DavinciMorph/InternalDataCollectionV2/CUBoard/CM4 (2).kicad_sch

## KiCad design CUBoard/CM4 (2).kicad_sch (2026-04-11)

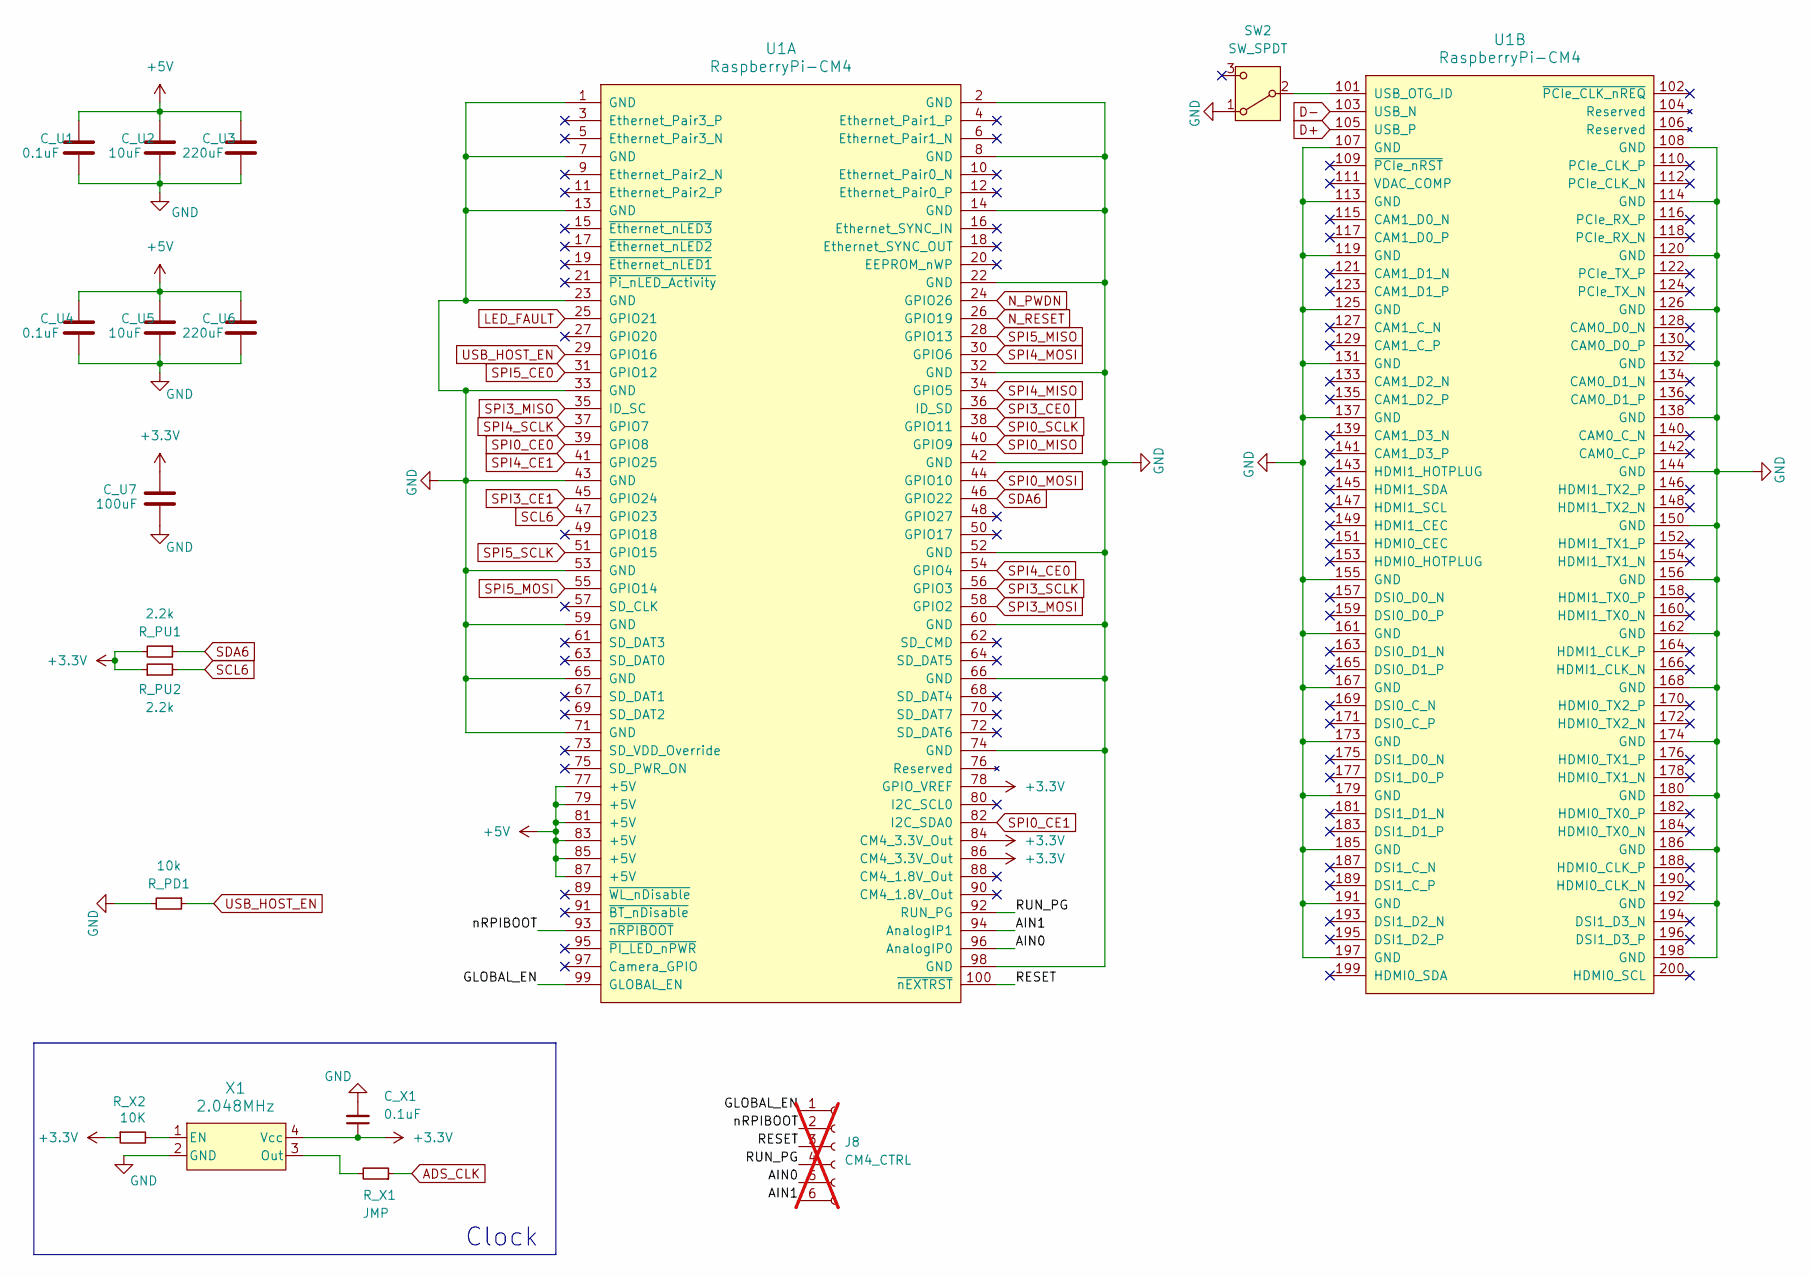
[picture p1: schematic CM4 (2).kicad_sch]

Parts:
C_U1, C_U4: 0.1uF; C_0402_1005Metric; MPN GRM155R71C104KA88J
C_U2, C_U5: 10uF; C_0805_2012Metric; MPN GRM21BR71A106KA73L
C_U3, C_U6: 220uF; CP_Elec_5x3; MPN APXT6R3ARA221ME61G
C_U7: 100uF; C_1206_3216Metric; MPN GRM31CR61A107MEA8L
C_X1: 0.1uF; C_0402_1005Metric; MPN GRM155R71C104KA88J
J8: CM4_CTRL; PinHeader_1x06_P2.54mm_Vertical; not fitted
R_PD1: 10k; R_0402_1005Metric; MPN RC0402FR-0710KL
R_PU1, R_PU2: 2.2k; R_0402_1005Metric; MPN RC0402FR-072K2L
R_X1: JMP; R_0402_1005Metric; MPN RC0402JR-070RL
R_X2: 10K; R_0402_1005Metric; MPN RC0402JR-070RL
SW2: SW_SPDT; SPDT_JS102011JCQN_CNK; MPN JS102011JCQN; JLC PN C221659
U1: RaspberryPi-CM4; Raspberry-Pi-4-Compute-Module
X1: 2.048MHz; IC4_632L3I002M04800_CTS; MPN 632L3I002M04800; JLC PN C2901549

Connections:
+3.3V: C_U7.1, C_X1.1, R_PU1.2, R_PU2.1, R_X2.1, U1.78 (GPIO_VREF), U1.84 (CM4_3.3V_Out), U1.86 (CM4_3.3V_Out), X1.4 (Vcc)
+5V: C_U1.1, C_U2.1, C_U3.1, C_U4.1, C_U5.1, C_U6.1, U1.77 (+5V), U1.79 (+5V), U1.81 (+5V), U1.83 (+5V), U1.85 (+5V), U1.87 (+5V)
ADS_CLK: R_X1.1
AIN0: J8.5, U1.96 (AnalogIP0)
AIN1: J8.6, U1.94 (AnalogIP1)
D+: U1.105 (USB_P)
D-: U1.103 (USB_N)
GLOBAL_EN: J8.1, U1.99 (GLOBAL_EN)
GND: C_U1.2, C_U2.2, C_U3.2, C_U4.2, C_U5.2, C_U6.2, C_U7.2, C_X1.2, R_PD1.2, SW2.1 (A), U1.1 (GND), U1.2 (GND), U1.7 (GND), U1.8 (GND), U1.13 (GND), U1.14 (GND), U1.22 (GND), U1.23 (GND), U1.32 (GND), U1.33 (GND), U1.42 (GND), U1.43 (GND), U1.52 (GND), U1.53 (GND), U1.59 (GND), U1.60 (GND), U1.65 (GND), U1.66 (GND), U1.71 (GND), U1.74 (GND), U1.98 (GND), U1.107 (GND), U1.108 (GND), U1.113 (GND), U1.114 (GND), U1.119 (GND), U1.120 (GND), U1.125 (GND), U1.126 (GND), U1.131 (GND), U1.132 (GND), U1.137 (GND), U1.138 (GND), U1.144 (GND), U1.150 (GND), U1.155 (GND), U1.156 (GND), U1.161 (GND), U1.162 (GND), U1.167 (GND), U1.168 (GND), U1.173 (GND), U1.174 (GND), U1.179 (GND), U1.180 (GND), U1.185 (GND), U1.186 (GND), U1.191 (GND), U1.192 (GND), U1.197 (GND), U1.198 (GND), X1.2 (GND)
LED_FAULT: U1.25 (GPIO21)
N_PWDN: U1.24 (GPIO26)
N_RESET: U1.26 (GPIO19)
unnamed: R_X1.2, X1.3 (Out)
unnamed: R_X2.2, X1.1 (EN)
unnamed: SW2.2 (B), U1.101 (USB_OTG_ID)
RESET: J8.3, U1.100 (~nEXTRST)
RUN_PG: J8.4, U1.92 (RUN_PG)
SCL6: R_PU2.2, U1.47 (GPIO23)
SDA6: R_PU1.1, U1.46 (GPIO22)
SPI0_CE0: U1.39 (GPIO8)
SPI0_CE1: U1.82 (I2C_SDA0)
SPI0_MISO: U1.40 (GPIO9)
SPI0_MOSI: U1.44 (GPIO10)
SPI0_SCLK: U1.38 (GPIO11)
SPI3_CE0: U1.36 (ID_SD)
SPI3_CE1: U1.45 (GPIO24)
SPI3_MISO: U1.35 (ID_SC)
SPI3_MOSI: U1.58 (GPIO2)
SPI3_SCLK: U1.56 (GPIO3)
SPI4_CE0: U1.54 (GPIO4)
SPI4_CE1: U1.41 (GPIO25)
SPI4_MISO: U1.34 (GPIO5)
SPI4_MOSI: U1.30 (GPIO6)
SPI4_SCLK: U1.37 (GPIO7)
SPI5_CE0: U1.31 (GPIO12)
SPI5_MISO: U1.28 (GPIO13)
SPI5_MOSI: U1.55 (GPIO14)
SPI5_SCLK: U1.51 (GPIO15)
USB_HOST_EN: R_PD1.1, U1.29 (GPIO16)
nRPIBOOT: J8.2, U1.93 (~nRPIBOOT)

Notes on the sheet:
Clock
