DavinciMorph/InternalDataCollectionV2/CUBoard/Peripherals (1).kicad_sch

## KiCad design CUBoard/Peripherals (1).kicad_sch (2026-04-11)

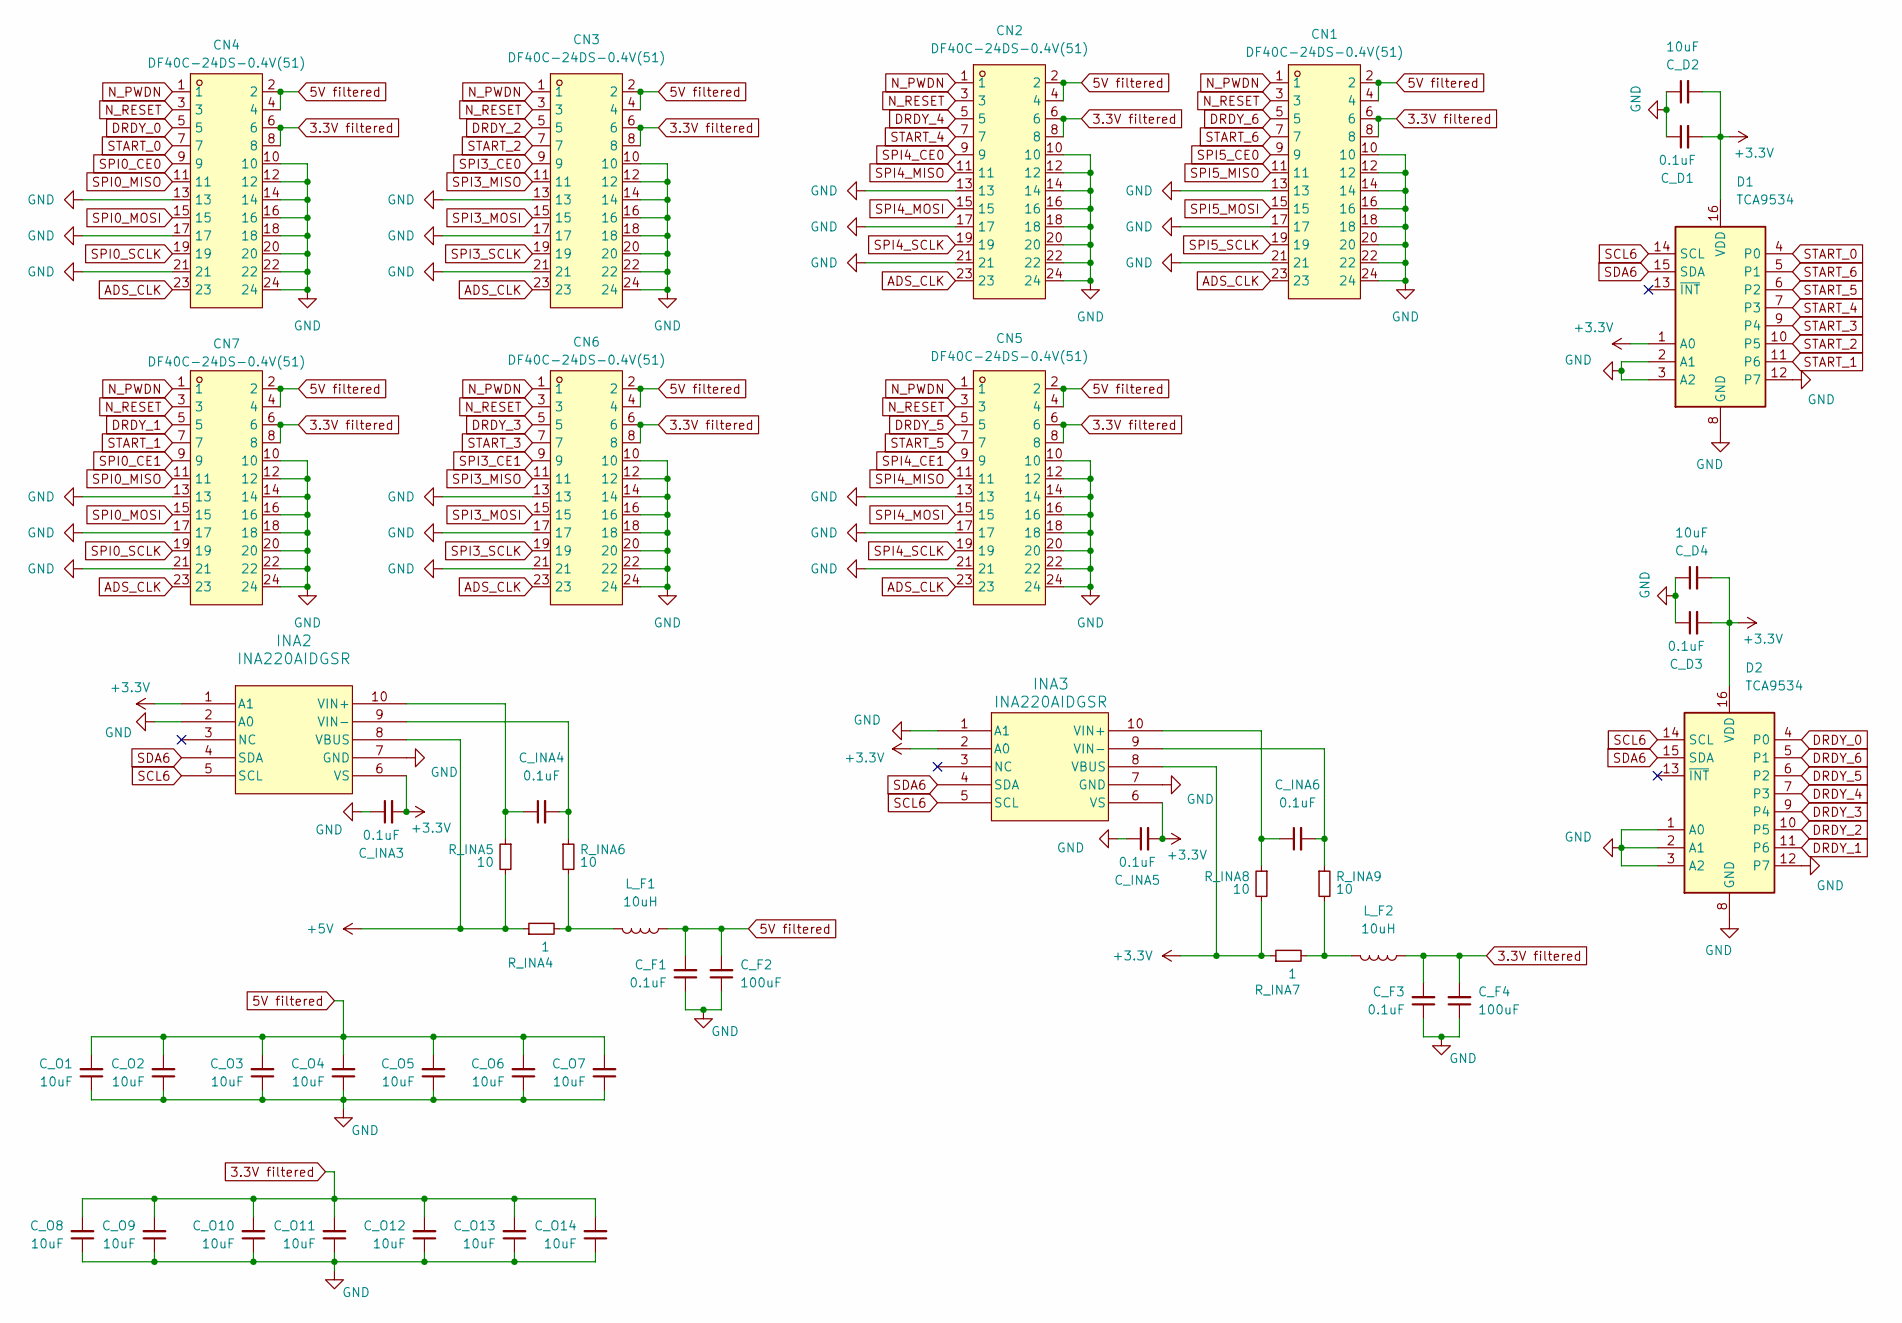
[picture p2: schematic Peripherals (1).kicad_sch]

Parts:
CN1, CN2, CN3, CN4, CN5, CN6, CN7: DF40C-24DS-0.4V(51); DF40C-24DS-0_4V_51; Manufacturer_Part_Number DF40C-24DS-0.4V(51); LCSC Part C424640
C_D1, C_D3: 0.1uF; C_0402_1005Metric; MPN GRM155R71C104KA88J
C_D2, C_D4: 10uF; C_0402_1005Metric; MPN GRM155R61A106ME11D
C_F1, C_F3: 0.1uF; C_0402_1005Metric; MPN GRM155R71C104KA88J
C_F2, C_F4: 100uF; C_1206_3216Metric; MPN GRM31CR61A107MEA8L
C_INA3, C_INA4, C_INA5, C_INA6: 0.1uF; C_0402_1005Metric; MPN GRM155R71C104KA88J
C_O1, C_O2, C_O3, C_O4, C_O5, C_O6, C_O7, C_O8, C_O9, C_O10, C_O11, C_O12, C_O13, C_O14: 10uF; C_0402_1005Metric; MPN GRM155R61A106ME11D
D1, D2: TCA9534; TSSOP-16_4.4x5mm_P0.65mm; MPN TCA9534PWR; JLC PN C783615
INA2, INA3: INA220AIDGSR; VSSOP-10_3x3mm_P0.5mm; MPN INA220AIDGSR; JLC PN C543040
L_F1, L_F2: 10uH; L_0603_1608Metric; MPN LBMF1608T100K
R_INA4, R_INA7: 1; R_0402_1005Metric; MPN RC0402FR-071RL
R_INA5, R_INA6, R_INA8, R_INA9: 10; R_0402_1005Metric; MPN RC0402FR-0710RL

Connections:
3.3V filtered: CN1.6, CN1.8, CN2.6, CN2.8, CN3.6, CN3.8, CN4.6, CN4.8, CN5.6, CN5.8, CN6.6, CN6.8, CN7.6, CN7.8, C_F3.2, C_F4.2, C_O8.2, C_O9.2, C_O10.2, C_O11.2, C_O12.2, C_O13.2, C_O14.2, L_F2.1
5V filtered: CN1.2, CN1.4, CN2.2, CN2.4, CN3.2, CN3.4, CN4.2, CN4.4, CN5.2, CN5.4, CN6.2, CN6.4, CN7.2, CN7.4, C_F1.2, C_F2.2, C_O1.2, C_O2.2, C_O3.2, C_O4.2, C_O5.2, C_O6.2, C_O7.2, L_F1.1
+3.3V: C_D1.2, C_D2.2, C_D3.2, C_D4.2, C_INA3.2, C_INA5.2, D1.1 (A0), D1.16 (VDD), D2.16 (VDD), INA2.1 (A1), INA2.6 (VS), INA3.2 (A0), INA3.6 (VS), INA3.8 (VBUS), R_INA7.1, R_INA8.2
+5V: INA2.8 (VBUS), R_INA4.1, R_INA5.2
ADS_CLK: CN1.23, CN2.23, CN3.23, CN4.23, CN5.23, CN6.23, CN7.23
DRDY_0: CN4.5, D2.4 (P0)
DRDY_1: CN7.5, D2.11 (P6)
DRDY_2: CN3.5, D2.10 (P5)
DRDY_3: CN6.5, D2.9 (P4)
DRDY_4: CN2.5, D2.7 (P3)
DRDY_5: CN5.5, D2.6 (P2)
DRDY_6: CN1.5, D2.5 (P1)
GND: CN1.10, CN1.12, CN1.13, CN1.14, CN1.16, CN1.17, CN1.18, CN1.20, CN1.21, CN1.22, CN1.24, CN2.10, CN2.12, CN2.13, CN2.14, CN2.16, CN2.17, CN2.18, CN2.20, CN2.21, CN2.22, CN2.24, CN3.10, CN3.12, CN3.13, CN3.14, CN3.16, CN3.17, CN3.18, CN3.20, CN3.21, CN3.22, CN3.24, CN4.10, CN4.12, CN4.13, CN4.14, CN4.16, CN4.17, CN4.18, CN4.20, CN4.21, CN4.22, CN4.24, CN5.10, CN5.12, CN5.13, CN5.14, CN5.16, CN5.17, CN5.18, CN5.20, CN5.21, CN5.22, CN5.24, CN6.10, CN6.12, CN6.13, CN6.14, CN6.16, CN6.17, CN6.18, CN6.20, CN6.21, CN6.22, CN6.24, CN7.10, CN7.12, CN7.13, CN7.14, CN7.16, CN7.17, CN7.18, CN7.20, CN7.21, CN7.22, CN7.24, C_D1.1, C_D2.1, C_D3.1, C_D4.1, C_F1.1, C_F2.1, C_F3.1, C_F4.1, C_INA3.1, C_INA5.1, C_O1.1, C_O2.1, C_O3.1, C_O4.1, C_O5.1, C_O6.1, C_O7.1, C_O8.1, C_O9.1, C_O10.1, C_O11.1, C_O12.1, C_O13.1, C_O14.1, D1.2 (A1), D1.3 (A2), D1.8 (GND), D1.12 (P7), D2.1 (A0), D2.2 (A1), D2.3 (A2), D2.8 (GND), D2.12 (P7), INA2.2 (A0), INA2.7 (GND), INA3.1 (A1), INA3.7 (GND)
N_PWDN: CN1.1, CN2.1, CN3.1, CN4.1, CN5.1, CN6.1, CN7.1
N_RESET: CN1.3, CN2.3, CN3.3, CN4.3, CN5.3, CN6.3, CN7.3
unnamed: C_INA4.1, INA2.10 (VIN+), R_INA5.1
unnamed: C_INA4.2, INA2.9 (VIN-), R_INA6.1
unnamed: C_INA6.1, INA3.10 (VIN+), R_INA8.1
unnamed: C_INA6.2, INA3.9 (VIN-), R_INA9.1
unnamed: L_F1.2, R_INA4.2, R_INA6.2
unnamed: L_F2.2, R_INA7.2, R_INA9.2
SCL6: D1.14 (SCL), D2.14 (SCL), INA2.5 (SCL), INA3.5 (SCL)
SDA6: D1.15 (SDA), D2.15 (SDA), INA2.4 (SDA), INA3.4 (SDA)
SPI0_CE0: CN4.9
SPI0_CE1: CN7.9
SPI0_MISO: CN4.11, CN7.11
SPI0_MOSI: CN4.15, CN7.15
SPI0_SCLK: CN4.19, CN7.19
SPI3_CE0: CN3.9
SPI3_CE1: CN6.9
SPI3_MISO: CN3.11, CN6.11
SPI3_MOSI: CN3.15, CN6.15
SPI3_SCLK: CN3.19, CN6.19
SPI4_CE0: CN2.9
SPI4_CE1: CN5.9
SPI4_MISO: CN2.11, CN5.11
SPI4_MOSI: CN2.15, CN5.15
SPI4_SCLK: CN2.19, CN5.19
SPI5_CE0: CN1.9
SPI5_MISO: CN1.11
SPI5_MOSI: CN1.15
SPI5_SCLK: CN1.19
START_0: CN4.7, D1.4 (P0)
START_1: CN7.7, D1.11 (P6)
START_2: CN3.7, D1.10 (P5)
START_3: CN6.7, D1.9 (P4)
START_4: CN2.7, D1.7 (P3)
START_5: CN5.7, D1.6 (P2)
START_6: CN1.7, D1.5 (P1)
