DavinciMorph/InternalDataCollectionV2/CUBoard/Power (1).kicad_sch

## KiCad design CUBoard/Power (1).kicad_sch (2026-04-11)

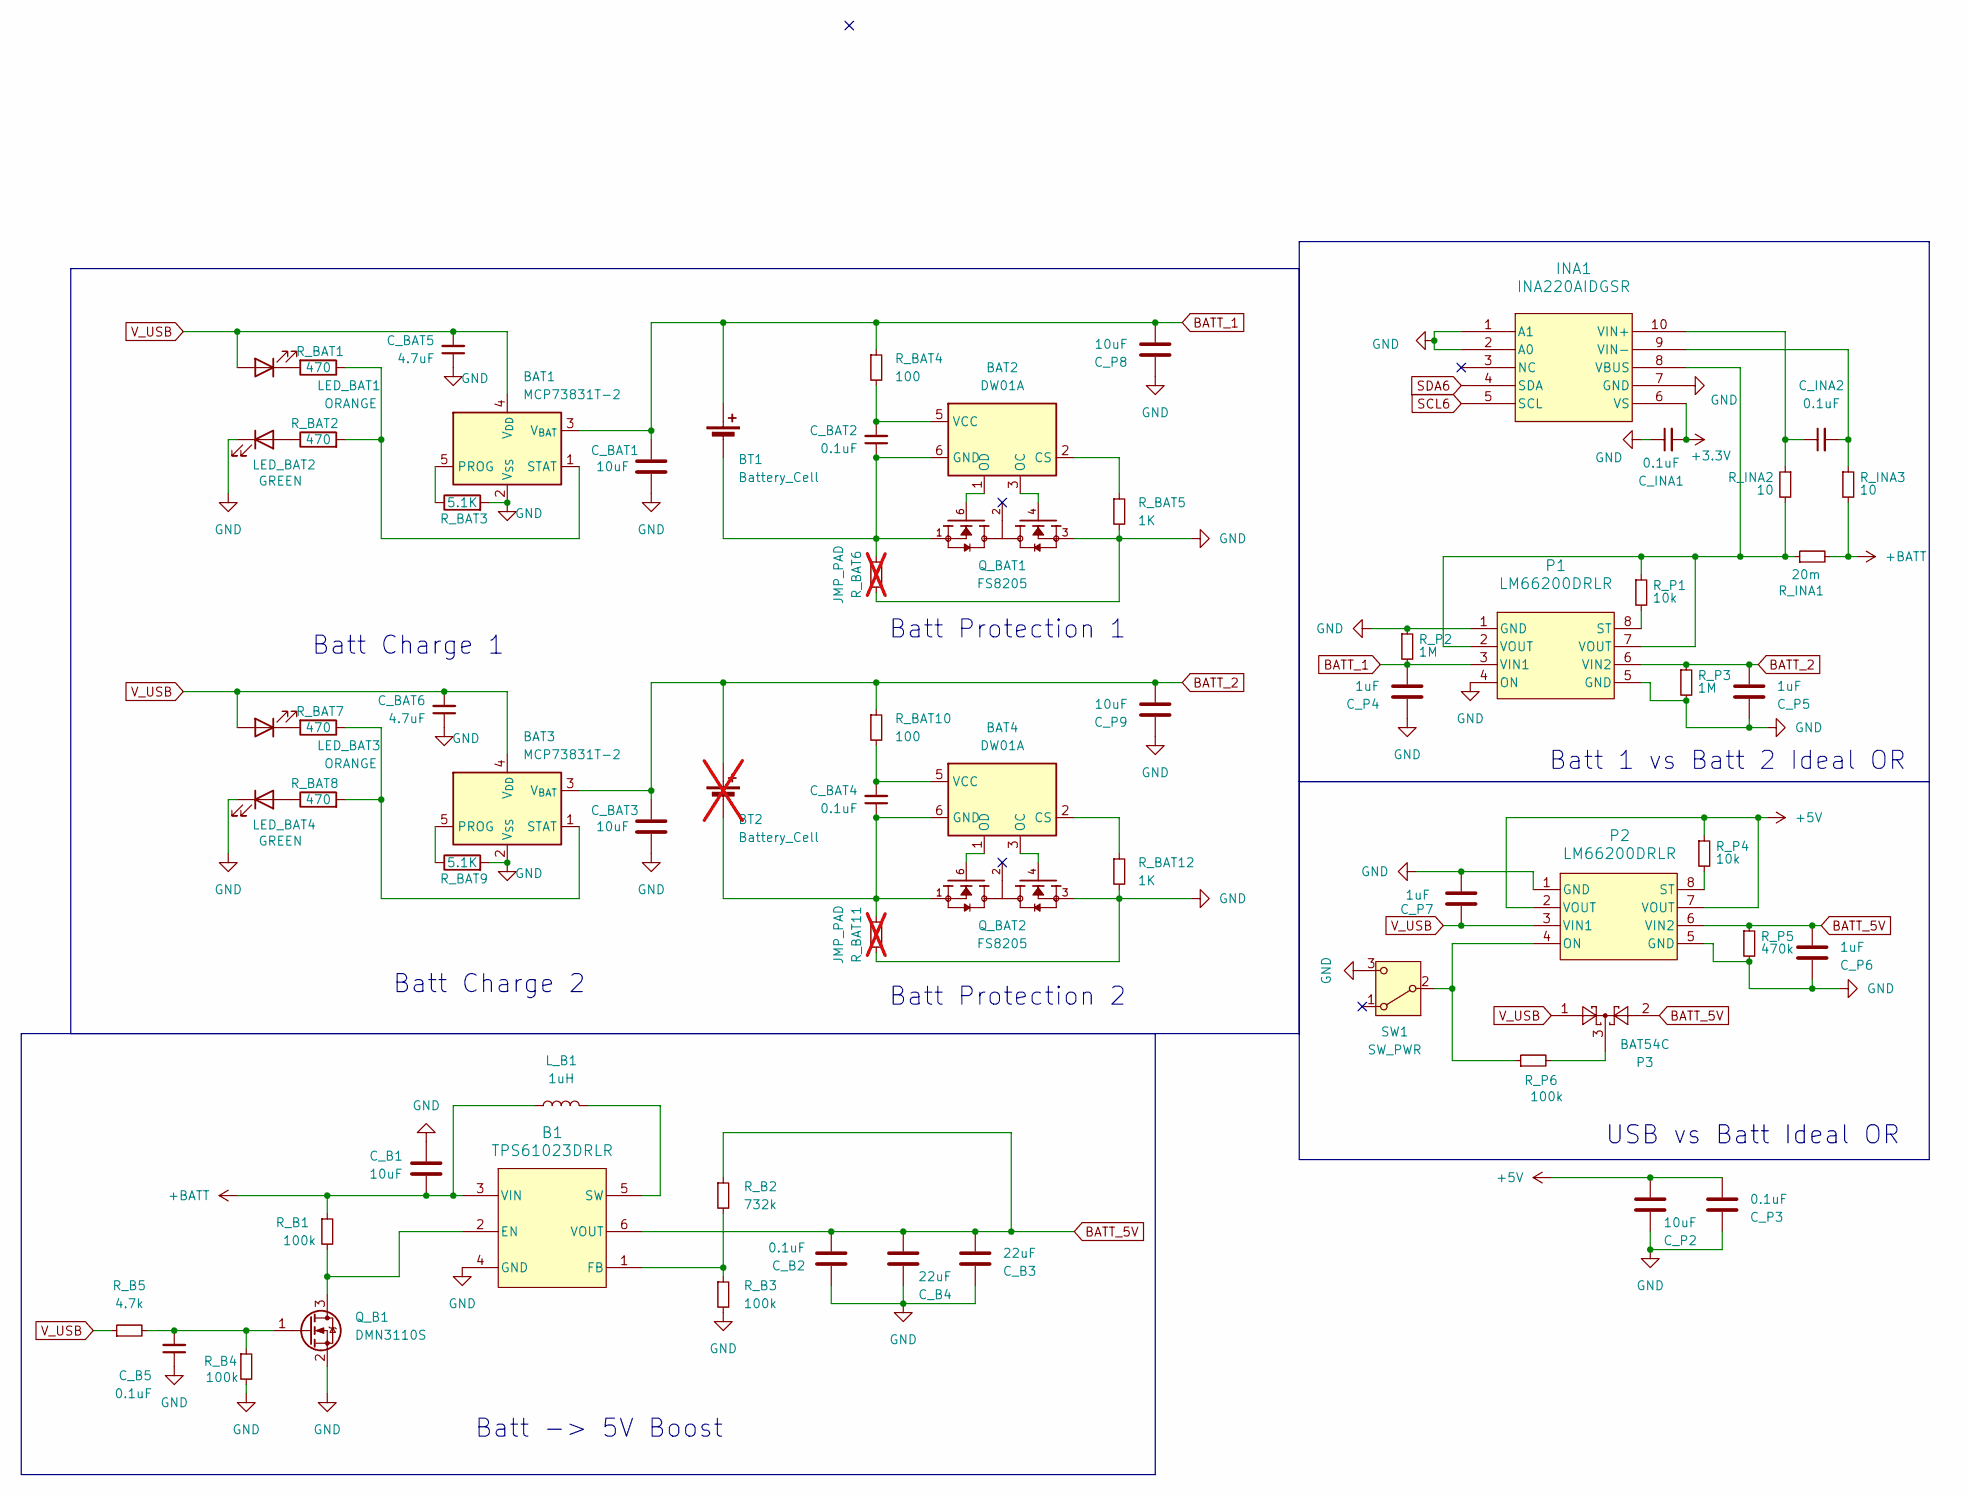
[picture p3: schematic Power (1).kicad_sch]

Parts:
B1: TPS61023DRLR; SOT-563; MPN TPS61023DRLR; JLC PN C919459
BAT1, BAT3: MCP73831T-2; SOT-23-5; MPN MCP73831T-2ACI/OT; JLC PN C424093
BAT2, BAT4: DW01A; SOT-23-6; MPN DW01A; JLC PN C351410
BT1: Battery_Cell; CONN_532610001-SD_02_MOL; MPN 0532610271; JLC PN C189700
BT2: Battery_Cell; CONN_532610001-SD_02_MOL; MPN 0532610271; JLC PN C189700; not fitted
C_B1: 10uF; C_0805_2012Metric; MPN GRM21BR71A106KA73L
C_B2, C_B5: 0.1uF; C_0402_1005Metric; MPN GRM155R71C104KA88J
C_B3, C_B4: 22uF; C_0805_2012Metric; MPN GRM21BZ71A226ME15L
C_BAT1, C_BAT3: 10uF; C_0805_2012Metric; MPN GRM21BR71A106KA73L
C_BAT2, C_BAT4: 0.1uF; C_0402_1005Metric; MPN GRM155R71C104KA88J
C_BAT5, C_BAT6: 4.7uF; C_0805_2012Metric; MPN GRM21BR71C475KE51L
C_INA1, C_INA2: 0.1uF; C_0402_1005Metric; MPN GRM155R71C104KA88J
C_P2, C_P8, C_P9: 10uF; C_0805_2012Metric; MPN GRM21BR71A106KA73L
C_P3: 0.1uF; C_0402_1005Metric; MPN GRM155R71C104KA88J
C_P4, C_P5, C_P6: 1uF; C_0805_2012Metric; MPN GCM21BR71H105KA03L
C_P7: 1uF; C_0603_1608Metric; MPN GCM188R71C105KA64D
INA1: INA220AIDGSR; VSSOP-10_3x3mm_P0.5mm; MPN INA220AIDGSR; JLC PN C543040
LED_BAT1, LED_BAT3: ORANGE; LED_0603_1608Metric; MPN LTST-C193KFKT-5A
LED_BAT2, LED_BAT4: GREEN; LED_0603_1608Metric; MPN LTST-C193KGKT-5A
L_B1: 1uH; L_Vishay_IHLP-2525; MPN IHLP2525CZER1R0M01; JLC PN C845018
P1, P2: LM66200DRLR; SOT-583-8; MPN LM66200DRLR; JLC PN C3235556
P3: BAT54C; SOT-23; MPN BAT54C; JLC PN BAT54C
Q_B1: DMN3110S; SOT-23; MPN DMN3110S-7; JLC PN C461016
Q_BAT1, Q_BAT2: FS8205; SOT95P280X145-6N; MPN FS8205A; JLC PN C908265
R_B1, R_B3, R_B4: 100k; R_0402_1005Metric; MPN RC0402FR-07100KL
R_B2: 732k; R_0402_1005Metric; MPN RC0402FR-07732KL
R_B5: 4.7k; R_0402_1005Metric; MPN RC0402FR-074K7L
R_BAT1, R_BAT2, R_BAT7, R_BAT8: 470; R_0402_1005Metric; MPN RC0402FR-13470RL
R_BAT3, R_BAT9: 5.1K; R_0402_1005Metric; MPN RC0402FR-075K1L
R_BAT4, R_BAT10: 100; R_0402_1005Metric; MPN RC0402FR-07100RL
R_BAT5, R_BAT12: 1K; R_0402_1005Metric; MPN RC0402FR-071KL
R_BAT6, R_BAT11: JMP_PAD; R_0402_1005Metric; MPN RC0402JR-070RL; not fitted
R_INA1: 20m; R_0402_1005Metric; MPN PA0402FRL7T0R02L
R_INA2, R_INA3: 10; R_0402_1005Metric; MPN RC0402FR-0710RL
R_P1, R_P4: 10k; R_0402_1005Metric; MPN RC0402FR-0710KL
R_P2, R_P3: 1M; R_0402_1005Metric; MPN RC0402FR-071ML
R_P5: 470k; R_0402_1005Metric; MPN RC0402FR-07470KL
R_P6: 100k; R_0402_1005Metric; MPN RC0402FR-07100KL
SW1: SW_PWR; EG1215AA; MPN EG1215AA; JLC PN C3664642

Connections:
+3.3V: C_INA1.2, INA1.6 (VS)
+5V: C_P2.1, C_P3.1, P2.2 (VOUT), P2.7 (VOUT), R_P4.1
+BATT: B1.3 (VIN), C_B1.1, L_B1.1, R_B1.1, R_INA1.2, R_INA3.2
BATT_1: BAT1.3 (V_{BAT}), BT1.1 (+), C_BAT1.1, C_P4.1, C_P8.1, P1.3 (VIN1), R_BAT4.1, R_P2.2
BATT_2: BAT3.3 (V_{BAT}), BT2.1 (+), C_BAT3.1, C_P5.1, C_P9.1, P1.6 (VIN2), R_BAT10.1, R_P3.1
BATT_5V: B1.6 (VOUT), C_B2.1, C_B3.1, C_B4.1, C_P6.1, P2.6 (VIN2), P3.2, R_B2.1, R_P5.1
GND: B1.4 (GND), BAT1.2 (V_{SS}), BAT3.2 (V_{SS}), C_B1.2, C_B2.2, C_B3.2, C_B4.2, C_B5.1, C_BAT1.2, C_BAT3.2, C_BAT5.1, C_BAT6.1, C_INA1.1, C_P2.2, C_P3.2, C_P4.2, C_P5.2, C_P6.2, C_P7.1, C_P8.2, C_P9.2, INA1.1 (A1), INA1.2 (A0), INA1.7 (GND), LED_BAT2.1 (K), LED_BAT4.1 (K), P1.1 (GND), P1.4 (ON), P1.5 (GND), P2.1 (GND), P2.5 (GND), Q_B1.2 (S), Q_BAT1.3, Q_BAT2.3, R_B3.2, R_B4.2, R_BAT3.2, R_BAT5.2, R_BAT6.1, R_BAT9.2, R_BAT11.1, R_BAT12.2, R_P2.1, R_P3.2, R_P5.2, SW1.3 (C)
unnamed: B1.1 (FB), R_B2.2, R_B3.1
unnamed: B1.2 (EN), Q_B1.3 (D), R_B1.2
unnamed: B1.5 (SW), L_B1.2
unnamed: BAT1.1 (STAT), R_BAT1.1, R_BAT2.2
unnamed: BAT1.5 (PROG), R_BAT3.1
unnamed: BAT2.1 (OD), Q_BAT1.6
unnamed: BAT2.2 (CS), R_BAT5.1
unnamed: BAT2.3 (OC), Q_BAT1.4
unnamed: BAT2.5 (VCC), C_BAT2.2, R_BAT4.2
unnamed: BAT2.6 (GND), BT1.2 (-), C_BAT2.1, Q_BAT1.1, R_BAT6.2
unnamed: BAT3.1 (STAT), R_BAT7.1, R_BAT8.2
unnamed: BAT3.5 (PROG), R_BAT9.1
unnamed: BAT4.1 (OD), Q_BAT2.6
unnamed: BAT4.2 (CS), R_BAT12.1
unnamed: BAT4.3 (OC), Q_BAT2.4
unnamed: BAT4.5 (VCC), C_BAT4.2, R_BAT10.2
unnamed: BAT4.6 (GND), BT2.2 (-), C_BAT4.1, Q_BAT2.1, R_BAT11.2
unnamed: C_B5.2, Q_B1.1 (G), R_B4.1, R_B5.2
unnamed: C_INA2.1, INA1.10 (VIN+), R_INA2.1
unnamed: C_INA2.2, INA1.9 (VIN-), R_INA3.1
unnamed: INA1.8 (VBUS), P1.2 (VOUT), P1.7 (VOUT), R_INA1.1, R_INA2.2, R_P1.1
unnamed: LED_BAT1.1 (K), R_BAT1.2
unnamed: LED_BAT2.2 (A), R_BAT2.1
unnamed: LED_BAT3.1 (K), R_BAT7.2
unnamed: LED_BAT4.2 (A), R_BAT8.1
unnamed: P1.8 (ST), R_P1.2
unnamed: P2.4 (ON), R_P6.1, SW1.2 (B)
unnamed: P2.8 (ST), R_P4.2
unnamed: P3.3, R_P6.2
unnamed: Q_BAT1.2, Q_BAT1.5
unnamed: Q_BAT2.2, Q_BAT2.5
SCL6: INA1.5 (SCL)
SDA6: INA1.4 (SDA)
V_USB: BAT1.4 (V_{DD}), BAT3.4 (V_{DD}), C_BAT5.2, C_BAT6.2, C_P7.2, LED_BAT1.2 (A), LED_BAT3.2 (A), P2.3 (VIN1), P3.1, R_B5.1

Notes on the sheet:
Batt 1 vs Batt 2 Ideal OR
Batt Charge 2
Batt Charge 1
Batt Protection 2
Batt -> 5V Boost
USB vs Batt Ideal OR
Batt Protection 1
