DavinciMorph/InternalDataCollectionV2/CUBoard/layout.kicad_sch

## KiCad design CUBoard/layout.kicad_sch (2026-04-11)

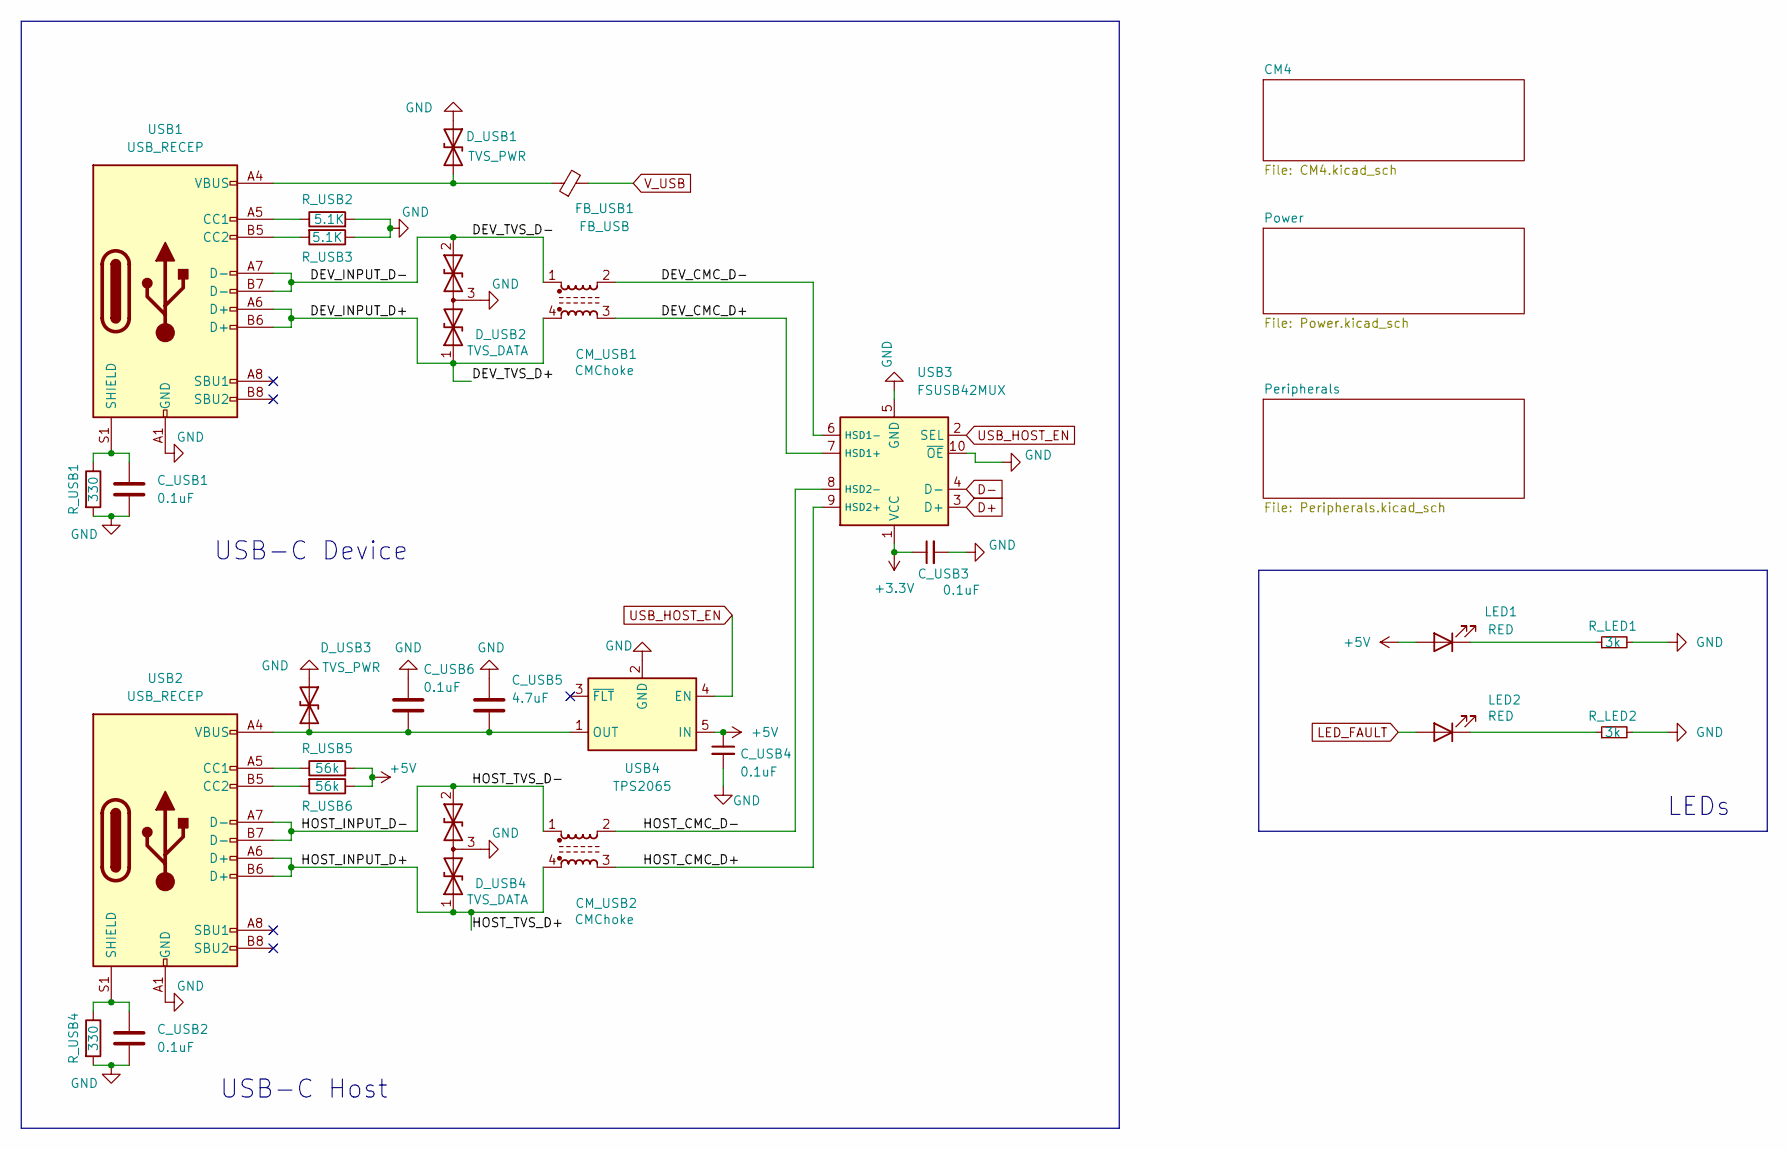
[picture p4: schematic layout.kicad_sch]

Parts:
CM_USB1, CM_USB2: CMChoke; DLM0NSM900HY2D_MUR; MPN DLM0NSM900HY2D; JLC PN C1857796
C_USB1, C_USB2, C_USB3, C_USB4, C_USB6: 0.1uF; C_0402_1005Metric; MPN GRM155R71C104KA88J
C_USB5: 4.7uF; C_0805_2012Metric; MPN GRM21BR71C475KE51L
D_USB1, D_USB3: TVS_PWR; D_SOD-323; MPN DESD5V0S1BA-7; JLC PN C177022
D_USB2, D_USB4: TVS_DATA; SOT-323_SC-70; MPN ESD7002WTT1G; JLC PN C233384
FB_USB1: FB_USB; L_0603_1608Metric; MPN BLM18AG601SN1D
LED1, LED2: RED; LED_0603_1608Metric; MPN LTST-C193KRKT-5A
R_LED1, R_LED2: 3k; R_0402_1005Metric; MPN RC0402FR-073KL
R_USB1, R_USB4: 330; R_0402_1005Metric; MPN RC0402FR-07330RL
R_USB2, R_USB3: 5.1K; R_0402_1005Metric; MPN RC0402FR-075K1L
R_USB5, R_USB6: 56k; R_0402_1005Metric; MPN RC0402FR-0756KL
USB1, USB2: USB_RECEP; GCT_USB4105-GF-A; MPN USB4105-GF-A; JLC PN C2765186
USB3: FSUSB42MUX; MSOP-10_3x3mm_P0.5mm; MPN FSUSB42MUX; JLC PN C11355
USB4: TPS2065; SOT-23-5; MPN TPS2065CDBVR; JLC PN C353882

Connections:
+3.3V: C_USB3.1, USB3.1 (VCC)
+5V: C_USB4.1, LED1.2 (A), R_USB5.2, R_USB6.1, USB4.5 (IN)
D+: USB3.3 (D+)
D-: USB3.4 (D-)
DEV_CMC_D+: CM_USB1.3, USB3.7 (HSD1+)
DEV_CMC_D-: CM_USB1.2, USB3.6 (HSD1-)
DEV_INPUT_D+: CM_USB1.4, D_USB2.1 (A1), USB1.A6 (D+), USB1.B6 (D+)
DEV_INPUT_D-: CM_USB1.1, D_USB2.2 (A2), USB1.A7 (D-), USB1.B7 (D-)
GND: C_USB1.2, C_USB2.2, C_USB3.2, C_USB4.2, C_USB5.1, C_USB6.1, D_USB1.1 (A1), D_USB2.3 (common), D_USB3.1 (A1), D_USB4.3 (common), R_LED1.2, R_LED2.2, R_USB1.2, R_USB2.2, R_USB3.1, R_USB4.2, USB1.A1 (GND), USB1.A12 (GND), USB2.A1 (GND), USB2.A12 (GND), USB3.5 (GND), USB3.10 (~OE), USB4.2 (GND)
HOST_CMC_D+: CM_USB2.3, USB3.9 (HSD2+)
HOST_CMC_D-: CM_USB2.2, USB3.8 (HSD2-)
HOST_INPUT_D+: CM_USB2.4, D_USB4.1 (A1), USB2.A6 (D+), USB2.B6 (D+)
HOST_INPUT_D-: CM_USB2.1, D_USB4.2 (A2), USB2.A7 (D-), USB2.B7 (D-)
LED_FAULT: LED2.2 (A)
unnamed: C_USB1.1, R_USB1.1, USB1.S1 (SHIELD)
unnamed: C_USB2.1, R_USB4.1, USB2.S1 (SHIELD)
unnamed: C_USB5.2, C_USB6.2, D_USB3.2 (A2), USB2.A4 (VBUS), USB2.A9 (VBUS), USB4.1 (OUT)
unnamed: D_USB1.2 (A2), FB_USB1.1, USB1.A4 (VBUS), USB1.A9 (VBUS)
unnamed: LED1.1 (K), R_LED1.1
unnamed: LED2.1 (K), R_LED2.1
unnamed: R_USB2.1, USB1.A5 (CC1)
unnamed: R_USB3.2, USB1.B5 (CC2)
unnamed: R_USB5.1, USB2.A5 (CC1)
unnamed: R_USB6.2, USB2.B5 (CC2)
USB_HOST_EN: USB3.2 (SEL), USB4.4 (EN)
V_USB: FB_USB1.2

Notes on the sheet:
USB-C Device
LEDs
USB-C Host
