DavinciMorph/InternalDataCollectionV2/pi/config.txt

# For more options and information see
# http://rptl.io/configtxt
# Some settings may impact device functionality. See link above for details

# Uncomment some or all of these to enable the optional hardware interfaces
#dtparam=i2c_arm=on
dtparam=i2c_arm=off
#dtparam=i2s=on
#dtparam=spi=on
dtoverlay=spi0-2cs,cs0_pin=8,cs1_pin=44
#dtoverlay=gpio-cs-overlay

# Enable additional hardware SPI buses for the CM4
dtoverlay=spi3-2cs
dtoverlay=spi3-dma
dtoverlay=spi4-2cs
dtoverlay=spi4-dma
dtoverlay=spi5-1cs
dtoverlay=dma40-expand
dtoverlay=spi5-dma
dtoverlay=ads1299

# Audio disabled — reduces EMI (no audio needed for headless acquisition)
dtparam=audio=off

# Additional overlays and parameters are documented
# /boot/firmware/overlays/README

# Camera/display auto-detect disabled — reduces periodic bus probing EMI
camera_auto_detect=0
display_auto_detect=0

# Automatically load initramfs files, if found
auto_initramfs=1

# Enable DRM VC4 V3D driver (HDMI output disabled to eliminate GPU EMI)
dtoverlay=vc4-kms-v3d,noaudio
max_framebuffers=0
hdmi_blanking=2

# Don't have the firmware create an initial video= setting in cmdline.txt.
# Use the kernel's default instead.
disable_fw_kms_setup=1

# Run in 64-bit mode
arm_64bit=1

# Disable compensation for displays with overscan
disable_overscan=1

# Run as fast as firmware / board allows
arm_boost=1

[cm4]
# Enable host mode on the 2711 built-in XHCI USB controller.
# This line should be removed if the legacy DWC2 controller is required
# (e.g. for USB device mode) or if USB support is not required.
otg_mode=1

[cm5]
dtoverlay=dwc2,dr_mode=host

[all]
# Disable Bluetooth — radio transceiver creates broadband EMI
dtoverlay=disable-bt

# Disable composite TV output — analog video DAC not needed
enable_tvout=0

dtoverlay=i2c-gpio,bus=6,i2c_gpio_sda=22,i2c_gpio_scl=23
