DavinciMorph/InternalDataCollectionV2/Cpp Implementation/src/acquisition/engine.cpp

#include "acquisition/engine.hpp"
#include "acquisition/bus_worker.hpp"
#include "acquisition/drdy_poller.hpp"
#include "ads1299/spi_device.hpp"
#include "ads1299/registers.hpp"
#include "streaming/server.hpp"

#include <cstdio>
#include <cstring>
#include <sched.h>
#include <pthread.h>
#include <sys/mman.h>
#include <fcntl.h>
#include <unistd.h>
#include <time.h>
#include <float.h>

namespace ads1299 {

double AcquisitionEngine::clock_now() {
    struct timespec ts;
    clock_gettime(CLOCK_MONOTONIC, &ts);
    return ts.tv_sec + ts.tv_nsec * 1e-9;
}

AcquisitionEngine::AcquisitionEngine(
    std::vector<ADS1299Device*>& devices,
    std::vector<BusWorker*>& workers,
    DRDYPoller& drdy_poller,
    SPSCRing<Sample>& ring)
    : devices_(devices)
    , workers_(workers)
    , drdy_poller_(drdy_poller)
    , ring_(ring)
    , num_ports_(static_cast<int>(devices.size()))
    , total_channels_(0)
    , total_samples_(0)
    , drdy_timeouts_(0)
    , corruption_count_(0)
    , drop_count_(0)
    , cycle_sum_ms_(0)
    , min_cycle_ms_(1e9)
    , max_cycle_ms_(0)
    , min_dt_ms_(1e9)
    , max_dt_ms_(0)
    , start_time_(0)
    , last_sample_time_(0)
    , last_stats_time_(0)
{
    std::memset(port_map_, 0, sizeof(port_map_));

    // Compute total channels and build port-to-worker mapping
    for (int p = 0; p < num_ports_; ++p) {
        total_channels_ += devices_[p]->config().num_devices * CHANNELS_PER_DEVICE;

        // Find which worker owns this port
        for (size_t w = 0; w < workers_.size(); ++w) {
            for (int wp = 0; wp < workers_[w]->port_count(); ++wp) {
                if (workers_[w]->device(wp) == devices_[p]) {
                    port_map_[p].worker_idx = static_cast<int>(w);
                    port_map_[p].port_idx_in_worker = wp;
                }
            }
        }
    }
}

void AcquisitionEngine::run(volatile sig_atomic_t& running) {
    // --- RT Hardening ---

    // Lock all pages — prevents page faults in hot loop
    mlockall(MCL_CURRENT | MCL_FUTURE);

    // Pre-fault stack (128KB)
    volatile char stack_prefault[128 * 1024];
    for (size_t i = 0; i < sizeof(stack_prefault); i += 4096) {
        stack_prefault[i] = 0;
    }

    // Prevent deep C-states (keep /dev/cpu_dma_latency open for process lifetime)
    int pm_fd = ::open("/dev/cpu_dma_latency", O_WRONLY);
    if (pm_fd >= 0) {
        int32_t zero = 0;
        ::write(pm_fd, &zero, sizeof(zero));
        // Keep fd open — closing would re-enable deep C-states
    }

    // Pin to isolated core 3
    cpu_set_t cpuset;
    CPU_ZERO(&cpuset);
    CPU_SET(3, &cpuset);
    pthread_setaffinity_np(pthread_self(), sizeof(cpu_set_t), &cpuset);

    // Set SCHED_FIFO priority 50
    struct sched_param param{};
    param.sched_priority = 50;
    sched_setscheduler(0, SCHED_FIFO, &param);

    std::printf("  Engine: core 3, SCHED_FIFO 50, mlockall, %d channels\n", total_channels_);

    // Pre-allocated sample for the hot loop
    Sample sample;
    std::memset(&sample, 0, sizeof(sample));
    sample.num_channels = static_cast<uint16_t>(total_channels_);

    start_time_ = clock_now();
    last_stats_time_ = start_time_;
    last_sample_time_ = 0;

    PortData port_data;

    while (running) {
        // 1. Poll DRDY via I2C (8ms timeout = corruption threshold)
        if (!drdy_poller_.poll(0.008)) {
            drdy_timeouts_++;
            continue;
        }

        double cycle_start = clock_now();

        // 2. Trigger all bus workers in parallel
        for (auto* w : workers_) {
            w->trigger();
        }

        // 3. Wait for all bus workers to complete
        for (auto* w : workers_) {
            w->wait_done();
        }

        // 4. Parse raw data into Sample struct
        double timestamp = cycle_start - start_time_;
        sample.timestamp = timestamp;
        sample.sample_number = static_cast<uint32_t>(total_samples_);
        sample.valid = true;

        int ch_idx = 0;
        for (int p = 0; p < num_ports_; ++p) {
            auto& pm = port_map_[p];
            auto* worker = workers_[pm.worker_idx];
            uint8_t* raw = worker->raw_buffer(pm.port_idx_in_worker);
            int num_dev = devices_[p]->config().num_devices;

            ADS1299Device::parse_raw(raw, num_dev, port_data);

            // Status byte validation (ALL devices in chain)
            for (int d = 0; d < num_dev; ++d) {
                if ((port_data.status_bytes[d][0] & 0xF0) != 0xC0) {
                    corruption_count_++;
                    sample.valid = false;
                    break;  // One bad device invalidates entire sample
                }
            }

            // B.5: Track first device's status byte per port
            last_status_bytes_[p] = port_data.status_bytes[0][0];

            // Copy channel values into sample
            for (int d = 0; d < num_dev; ++d) {
                for (int c = 0; c < CHANNELS_PER_DEVICE; ++c) {
                    sample.channels[ch_idx++] = port_data.channel_values[d][c];
                }
            }
        }

        // B.1: DC offset watchdog (integer arithmetic only, zero allocation)
        if (!baseline_locked_) {
            // Accumulate running sums for baseline computation
            for (int c = 0; c < total_channels_; ++c) {
                channel_running_sum_[c] += sample.channels[c];
            }
            baseline_samples_++;
            if (baseline_samples_ >= BASELINE_WINDOW) {
                for (int c = 0; c < total_channels_; ++c) {
                    channel_baseline_[c] = static_cast<int32_t>(
                        channel_running_sum_[c] / static_cast<int64_t>(baseline_samples_));
                }
                baseline_locked_ = true;
            }
        } else {
            // Compare each channel to baseline
            int alert_count = 0;
            int32_t max_off = 0;
            for (int c = 0; c < total_channels_; ++c) {
                int32_t diff = sample.channels[c] - channel_baseline_[c];
                int32_t abs_diff = diff < 0 ? -diff : diff;
                if (abs_diff > OFFSET_THRESHOLD) {
                    alert_count++;
                }
                if (abs_diff > max_off) {
                    max_off = abs_diff;
                }
            }
            offset_alert_ = (alert_count > 0);
            offset_alert_count_ = alert_count;
            max_offset_ = max_off;

            // B.1c: Track alert onset time (rising edge detection)
            if (offset_alert_ && !offset_alert_prev_) {
                offset_alert_onset_time_ = timestamp;  // Record onset
            } else if (!offset_alert_ && offset_alert_prev_) {
                offset_alert_onset_time_ = 0.0;  // Alert cleared
            }
            offset_alert_prev_ = offset_alert_;
        }

        // B.1b: Per-port mean EMA update (exponential moving average, alpha=1/64)
        //   For each port, compute the mean of its channels, then update the EMA.
        //   EMA stored as Q8 fixed-point: ema = ema - (ema >> 6) + (mean << 2)
        //   This is equivalent to alpha=1/64 with Q8 precision.
        {
            int ch_base = 0;
            for (int p = 0; p < num_ports_; ++p) {
                int n_ch = devices_[p]->config().num_devices * CHANNELS_PER_DEVICE;
                int64_t sum = 0;
                for (int c = 0; c < n_ch; ++c) {
                    sum += sample.channels[ch_base + c];
                }
                // mean in LSB (integer division)
                int64_t mean_lsb = sum / n_ch;
                // Update EMA: Q8 format, alpha=1/64
                // ema = ema + (mean_Q8 - ema) / 64
                int64_t mean_q8 = mean_lsb << 8;
                port_mean_ema_[p] += (mean_q8 - port_mean_ema_[p]) >> 6;

                ch_base += n_ch;
            }
            // Snapshot baseline EMA after the baseline window locks
            if (baseline_locked_ && !port_baseline_set_ &&
                baseline_samples_ == BASELINE_WINDOW) {
                for (int p = 0; p < num_ports_; ++p) {
                    port_baseline_ema_[p] = port_mean_ema_[p];
                }
                port_baseline_set_ = true;
            }
        }

        // B.6: Supply voltage monitor — track MVDD channel min/max
        if (supply_channel_idx_ >= 0 && supply_channel_idx_ < ch_idx) {
            int32_t v = sample.channels[supply_channel_idx_];
            supply_value_ = v;
            if (v < supply_min_) supply_min_ = v;
            if (v > supply_max_) supply_max_ = v;
        }

        // 5. Non-blocking push to SPSC ring buffer (CSV) — skipped when no CSV consumer
        if (csv_enabled_) {
            if (!ring_.try_push(sample)) {
                drop_count_++;
            }
        }

        // 5b. Non-blocking push to streaming ring buffer (TCP)
        if (streaming_) {
            streaming_->push_sample(sample);
        }

        // 6. Timing instrumentation
        double cycle_end = clock_now();
        double cycle_ms = (cycle_end - cycle_start) * 1000.0;
        cycle_sum_ms_ += cycle_ms;
        if (cycle_ms < min_cycle_ms_) min_cycle_ms_ = cycle_ms;
        if (cycle_ms > max_cycle_ms_) max_cycle_ms_ = cycle_ms;

        if (last_sample_time_ > 0) {
            double dt_ms = (cycle_start - last_sample_time_) * 1000.0;
            if (dt_ms < min_dt_ms_) min_dt_ms_ = dt_ms;
            if (dt_ms > max_dt_ms_) max_dt_ms_ = dt_ms;
        }
        last_sample_time_ = cycle_start;

        total_samples_++;

        // 7. Signal stats thread every 10 seconds (zero syscalls on RT core)
        if (cycle_end - last_stats_time_ >= STATS_INTERVAL_SEC) {
            stats_ready_.store(true, std::memory_order_release);
            last_stats_time_ = cycle_end;
        }
    }

    // Signal final stats
    stats_ready_.store(true, std::memory_order_release);

    if (pm_fd >= 0) {
        ::close(pm_fd);
    }
}

AcquisitionEngine::Stats AcquisitionEngine::get_stats() const {
    Stats s{};
    s.total_samples = total_samples_;
    s.drdy_timeouts = drdy_timeouts_;
    s.corruption_count = corruption_count_;
    s.drop_count = drop_count_;
    s.min_cycle_ms = min_cycle_ms_;
    s.max_cycle_ms = max_cycle_ms_;
    s.mean_cycle_ms = total_samples_ > 0 ? cycle_sum_ms_ / total_samples_ : 0;
    s.min_dt_ms = min_dt_ms_;
    s.max_dt_ms = max_dt_ms_;
    s.runtime_sec = clock_now() - start_time_;
    // B.1: DC offset watchdog
    s.offset_alert = offset_alert_;
    s.offset_alert_count = offset_alert_count_;
    s.max_offset = max_offset_;
    s.offset_alert_onset = offset_alert_onset_time_;
    // B.1b: Per-port mean offset from baseline
    s.num_offset_ports = num_ports_;
    for (int p = 0; p < num_ports_ && p < MAX_PORTS; ++p) {
        if (port_baseline_set_) {
            // Convert Q8 EMA difference back to integer LSB
            s.port_offset[p] = static_cast<int32_t>(
                (port_mean_ema_[p] - port_baseline_ema_[p]) >> 8);
        } else {
            s.port_offset[p] = 0;
        }
    }
    // B.6: Supply voltage monitor
    s.supply_monitor_active = (supply_channel_idx_ >= 0);
    s.supply_value = supply_value_;
    s.supply_min = supply_min_;
    s.supply_max = supply_max_;
    // Note: min/max are NOT reset here to preserve full-session extremes.
    // The stats thread can compute per-interval deltas externally if needed.

    // B.5: Status byte tracking
    s.num_status_ports = num_ports_;
    for (int p = 0; p < num_ports_ && p < MAX_PORTS; ++p) {
        s.status_bytes[p] = last_status_bytes_[p];
    }
    return s;
}

} // namespace ads1299
