DavinciMorph/InternalDataCollectionV2/(commit log)

2026-02-17 Initial commit: organized workspace for ADS1299 EEG acquisition system
    - client/ — simpleviz.py (PyQt5 real-time EEG visualizer)
    - server/ — ControllerPhase1.py (Pi acquisition server)
    - testing/ — Controller.py, csvviewer.py, check_corruption.py, dummy_client.py
    - pi/ — DMA overlays, boot config, mux scripts, setup docs
    - info/ — datasheets, session notes, changelogs
    - archive/ — old server versions and retired scripts
    [OLDconfig.txt, config.txt]
2026-02-18 Init sequence optimization: reduce init time by ~30s with zero corruption
    Phase 1 A/B testing of ADS1299 init sequence timing parameters.
    Each change was tested independently with 5+ minute runs (>75k samples)
    requiring zero corruption to pass, with confirmation runs.
    Accepted optimizations (ControllerPhase1.py):
    - num_resets: 5 → 2 (saves ~29.4s)
    - reset_time: 1.0+(N*0.1) → 0.1+(N*0.01) (saves ~17.6s)
    - Reference buffer settling: 500ms → 200ms (saves ~2.1s)
    - Post-RDATAC settling: 750ms → 200ms (saves ~0.55s)
    - Post-START sync wait: 500ms → 100ms (saves ~0.4s)
    - write_and_verify sleep: 100ms → 10ms (saves ~8.2s)
    Reverted (caused init failures):
    - Test 9: Removing 1000ms stabil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
    [Controller.py, ControllerPhase1.py, check_corruption.py, csvviewer.py, simpleviz.py]
2026-02-18 Phase 1 complete: final validation + revert failed tests (9, 11, 12)
    Final validation: 323,750 samples over 21.6 min, 1 corrupt sample
    (8.2ms stall, 0.000154% rate). Init optimizations solid — corruption
    is from Python GIL/spidev overhead leaving no headroom for OS jitter.
    Reverted tests:
    - Test 9: Removing stabilization wait increased init failures
    - Test 11: Reducing SDATAC sends increased init failures
    - Test 12: Parallel port init caused real data corruption + I2C contention
    Moving to Phase 2: C++ hot loop migration for faster SPI reads.
    [ControllerPhase1.py]
2026-02-18 Add C++ acquisition engine (Phase 1: acquisition + CSV)
    Complete C++20 rewrite of the Python acquisition hot loop for Raspberry Pi 4.
    Architecture: direct SPI ioctl, eventfd bus workers, SPSC ring buffer,
    SCHED_FIFO on isolated core 3, zero heap allocation in hot loop.
    First validation: 23.3 min, 349k samples, 224 channels, zero corruption,
    250 Hz locked, max dt 4.66ms (vs Python's 8.2ms stalls).
    [bus_worker.cpp, controller.cpp, controller.hpp, drdy_poller.cpp, drdy_poller.hpp]
2026-02-18 Add Phase 2 TCP streaming to C++ acquisition engine (7 ports, 4 devices/port, 224ch @ 250Hz)
    Adds LZ4-compressed binary TCP streaming as a parallel output path alongside CSV,
    wire-compatible with the existing simpleviz.py client. Validated over 20.6 min
    (308k samples): zero corruption, zero drops, full 250 Hz client delivery.
    - New: streaming/protocol.{hpp,cpp} — wire protocol (pack, metadata JSON, send_all)
    - New: streaming/server.{hpp,cpp} — StreamingServer (accept thread core 1, stream thread core 2)
    - Separate SPSC ring for streaming (fault-isolated from CSV ring)
    - LZ4 streaming API (zero per-call allocations), pre-allocated buffers
    - SIGPIPE protection, TCP keepalive, periodic rec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
2026-02-19 Phase B2: eliminate SPI corruption via RT isolation + client-side CSV
    Root cause: SD card EMMC2 DMA writeback saturated the AXI bus, stalling
    all 4 SPI DMA controllers simultaneously and causing ADS1299 shift
    register bit-alignment failures on CS1 ports.
    Server changes:
    - Remove printf() from RT hot loop; stats printed by separate thread
    - Isolate cores 2,3 (nohz_full, rcu_nocbs, irqaffinity=0,1)
    - Move CSV/streaming/accept/stats threads to core 1 (housekeeping)
    - Default to --no-csv; CSV writing moved to client side
    - Fix health check: ports <50% valid trigger recovery
    - Bus workers: mlockall + 64KB stack pre-fault
    Client changes:
    - Add CSVWriterThread to simpleviz.py (async, non-blocking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
    [bus_worker.cpp, controller.cpp, controller.hpp, engine.cpp, engine.hpp, main.cpp]
2026-02-19 Tiered recovery init redesign + 7/7 hard gate + dead port exclusion
    Replace flat 15-attempt recover_port() loop with 3-tier strategy:
    - Tier 1: RDATAC cycle (~200ms, 8 attempts) — fixes timing race
    - Tier 2: Software RESET + register reconfig (~500ms, 5 attempts) — fixes latch failures
    - Tier 3: Full re-init all ports (~30s, 2 rounds) — last resort
    Removed counterproductive escalating delays (memoryless timing race).
    Added 7/7 hard gate: system exits with "power cycle required" (exit code 2)
    if any port fails all recovery tiers. --min-ports flag as escape hatch.
    Dead port exclusion: filtered active_devices/active_configs vectors passed
    to all downstream components so dead ports canno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
    [check_corruption.py, controller.cpp, controller.hpp, csvviewer.py, main.cpp]
2026-03-07 Remove LZ4 compression from TCP streaming, send raw samples
    LZ4 batch compression (BATCH_SIZE=10) was causing a 25 Hz artifact
    (Fs/10) in ADC data. The periodic CPU burst from compressing 10
    samples at once created power supply transients that coupled into
    the ADS1299 analog reference. Confirmed via folded-sample analysis
    showing deterministic perturbation at batch boundary positions.
    - Remove LZ4 compression entirely from streaming server
    - Remove liblz4 dependency from CMakeLists.txt
    - Set BATCH_SIZE=1 to eliminate batch-boundary artifacts
    - Send raw packed samples over TCP (227 KB/s, trivial for WiFi)
    - Update client (simpleviz.py) to receive raw data without LZ4
    - Wire protocol unchange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
2026-03-07 Reduce I2C EMI spikes + production defaults + robust init/recovery
    - Add usleep(200) between DRDY polls to reduce GPIO bit-bang EMI
    (97% reduction in common-mode spikes on high-impedance electrodes)
    - Change defaults from test signal to normal mode (gain=24, Port1=8 devices)
    - Add write-once init path (no WREG/RREG cycling corruption)
    - Strengthen SDATAC/RDATAC/flush sequences (multi-send for daisy chains)
    - Add CLI args: --test-signal, --sps, --config3, --chnset
    - Clean shutdown: SDATAC x10 + flush on exit
    [controller.cpp, controller.hpp, drdy_poller.cpp, main.cpp, registers.hpp, types.hpp]
2026-03-08 DRDY 2500Hz poll lock + BIAS support + EMI config + doc consolidation
    - Lock DRDY poll rate to 2500 Hz via clock_nanosleep absolute-time grid
    (eliminates 71.5 Hz I2C EMI alias — aliases now land at DC)
    - Add --bias-port N CLI flag with per-port DeviceConfig array
    (CONFIG3 PD_BIAS, BIAS_SENSP/SENSN routing, CH8SET BIAS_DRP output)
    - Disable GPU + BT + audio + camera/display probing in pi/config.txt
    (4x reduction in 70 Hz EMI on clean channels)
    - Consolidate 35 scattered .md files into 11 focused documents
    - Clean up one-off analysis scripts, debug logs, and investigation artifacts
    [config.txt]
2026-03-08 Fix Port4 and Port5 device counts: 4 → 5 (42 devices, 336 channels)
    [types.hpp]
2026-03-29 Increase Tier 1 RDATAC cycling from 8 to 100 attempts per port
    The RDATAC output pipeline has a timing race after Phase 1's WREG/RREG
    cycling that requires multiple SDATAC→RDATAC cycles to clear. 8 attempts
    was insufficient in high-EMI environments (iPhone hotspot, new locations).
    100 attempts provides ample margin — typical recovery takes 5-54 attempts.
    [main.cpp]
2026-04-11 Snapshot work-in-progress for Mac migration
    Bundles all current local work — C++ acquisition changes (impedance
    module, engine/drdy_poller/controller updates), new client/eeg_app
    PyQt application, analysis scripts (firmware_issue1, inductor,
    rereference, task_a*, test_signal_sync, stage1-3), CUBoard KiCad
    schematics, Pi-side C++ tree copy, and WiFi hotspot docs.
    Large recording/notebook/video directories excluded via .gitignore
    (experiment_data, notebooks, Force, videos, gestures, *_output/,
    *.mov, client-level *.png/*.npy) to keep the repo clonable on the
    Mac. No code/doc changes beyond what's listed above — this is purely
    a transport commit so the migration can resume from a clean che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
    [CM4 (2).kicad_sch, Peripherals (1).kicad_sch, Power (1).kicad_sch, layout.kicad_sch]
2026-04-14 Point deploy script at MorphAP Pi + Pi snapshot source tree
    Marks the current known working state of the system as of 2026-04-14.
    Deploy target updated from the old CM4 (192.168.1.99) to the active Pi
    at 10.42.0.1 (MorphAP), and source base switched from "Cpp Implementation"
    to the "Cpp Implementation (Pi)" snapshot pulled from the active Pi.
